adafruit/Feather-RISC-V-PCB/(commit log)

2017-09-10 This is Rev B. Rev A had the incorrect RISC-V footprint.
    [feather_five-B.Cu.gbr, feather_five-B.Mask.gbr, feather_five-B.SilkS.gbr, feather_five-Edge.Cuts.gbr, feather_five-F.Cu.gbr, feather_five-F.Mask.gbr, feather_five-F.SilkS.gbr, feather_five-NPTH.drl]
2017-09-15 Schematic and PCB fixes per email discussion
    - Updates FE310 symbol for pin swap.
    - Moves R2 on schematic and PCB per pin swap.
    - Removes GND from PLL_AVSS.
    - Moves C5 to facilitate routing.
    - Placement and routing tweaks.
    - Close soldermask openings a bit.
    [feather_five.kicad_pcb, feather_five.sch]
